hajrudin10/AndreiUW/KiCAD/V_01_00/Proximity_sensor_V_01_00/Prox_sens_V_01_00/Prox_sens_V_01_00_bot.png

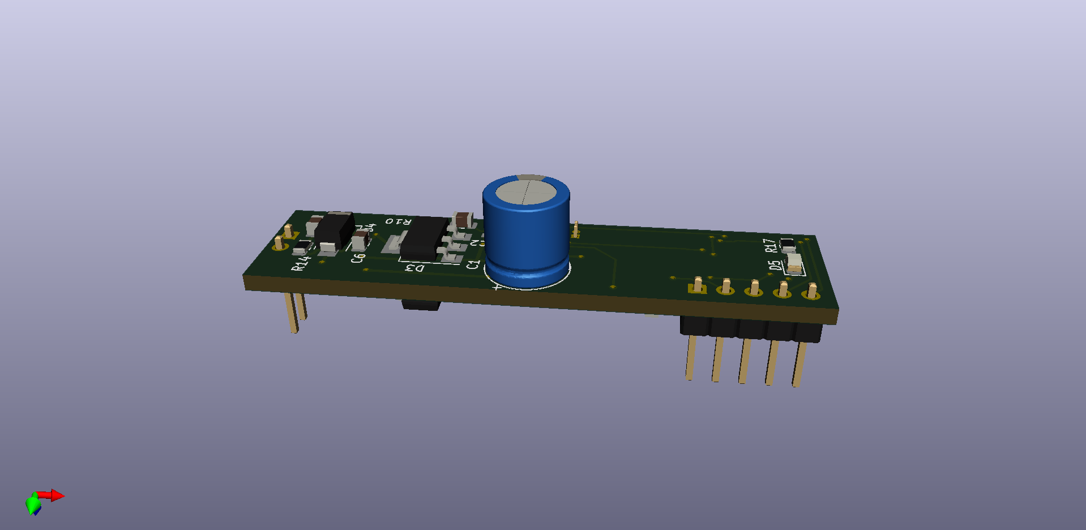
KiCAD/V_01_00/Proximity_sensor_V_01_00/Prox_sens_V_01_00/Prox_sens_V_01_00_bot.png
