hajrudin10/AndreiUW/TwoWireProximitySensor.pdf

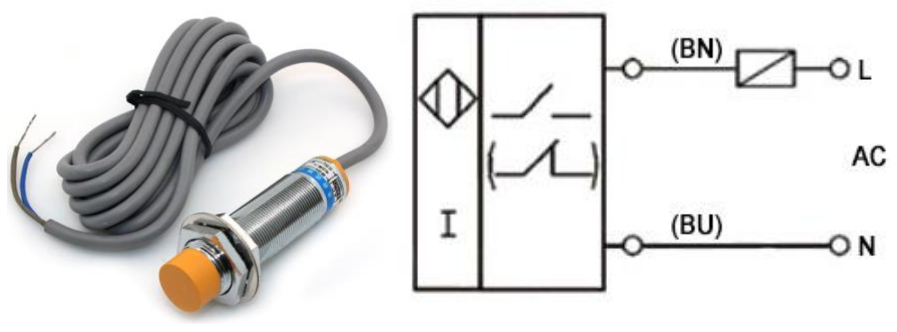
[picture p3: figure]

1. Design done in KiCAD
2. 230V input MP103GN based AC-DC 5V power supply
3. CY8C4014LQI-421 IC controls thyristor state + Capacitive Sensing connection
4. Zero crossing detection connected to CY8C4014LQI-421
5. M24SR02-Y (TSSOP8 package) NFC IC, connected to CY8C4014LQI-421 via I2C
6. PCB size: width 14mm, length <=55mm

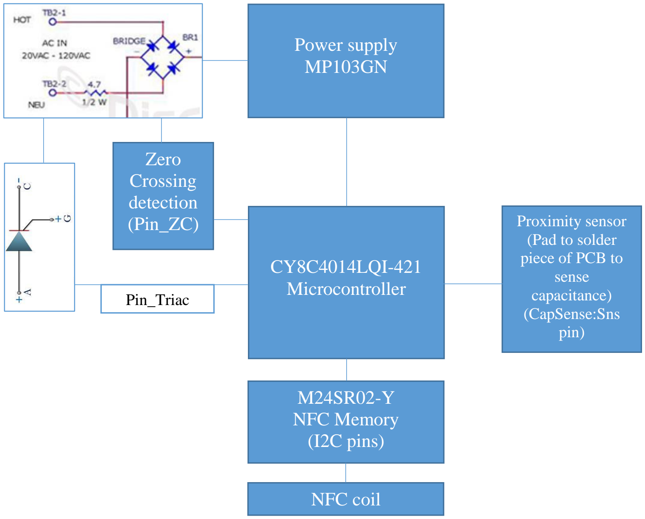
[picture p4: figure]
Power supply MP103GN; CY8C4014LQI-421 Microcontroller; Proximity sensor (Pad to solder piece of PCB to sense capacitance) (CapSense:Sns pin); M24SR02-Y NFC Memory (I2C pins); NFC coil; Zero Crossing detection (Pin_ZC); Pin_Triac

Functional diagram

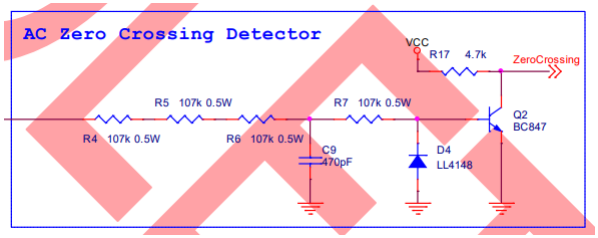
[picture p5: figure]

Zero Crossing detection

Thyristor gate control circuit

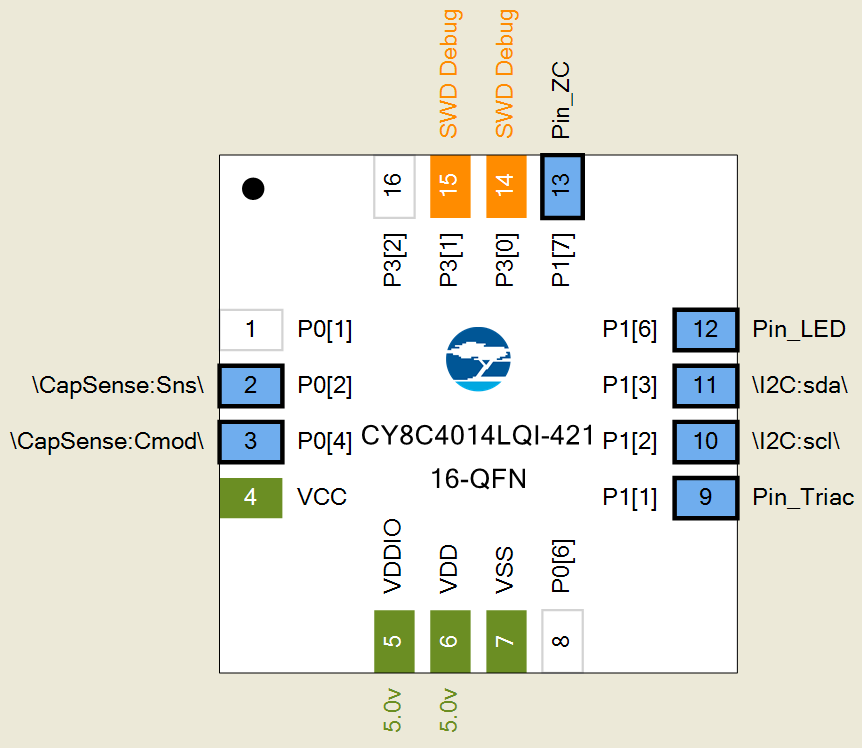
[picture p6: figure]

CapSense:Cmod – Capacitor connected to GND 2.2nF CapSense:Sns – Connected to proximity sensor
Pin_ZC – Connected to zeroCrossing detector output Pin_Triac – Thyristor control output
SWD Debug – Connected to programming pads on PCB Pin_LED – Status LED located on PCB
