hajrudin10/AndreiUW/Zero_crossing_detector2.PNG

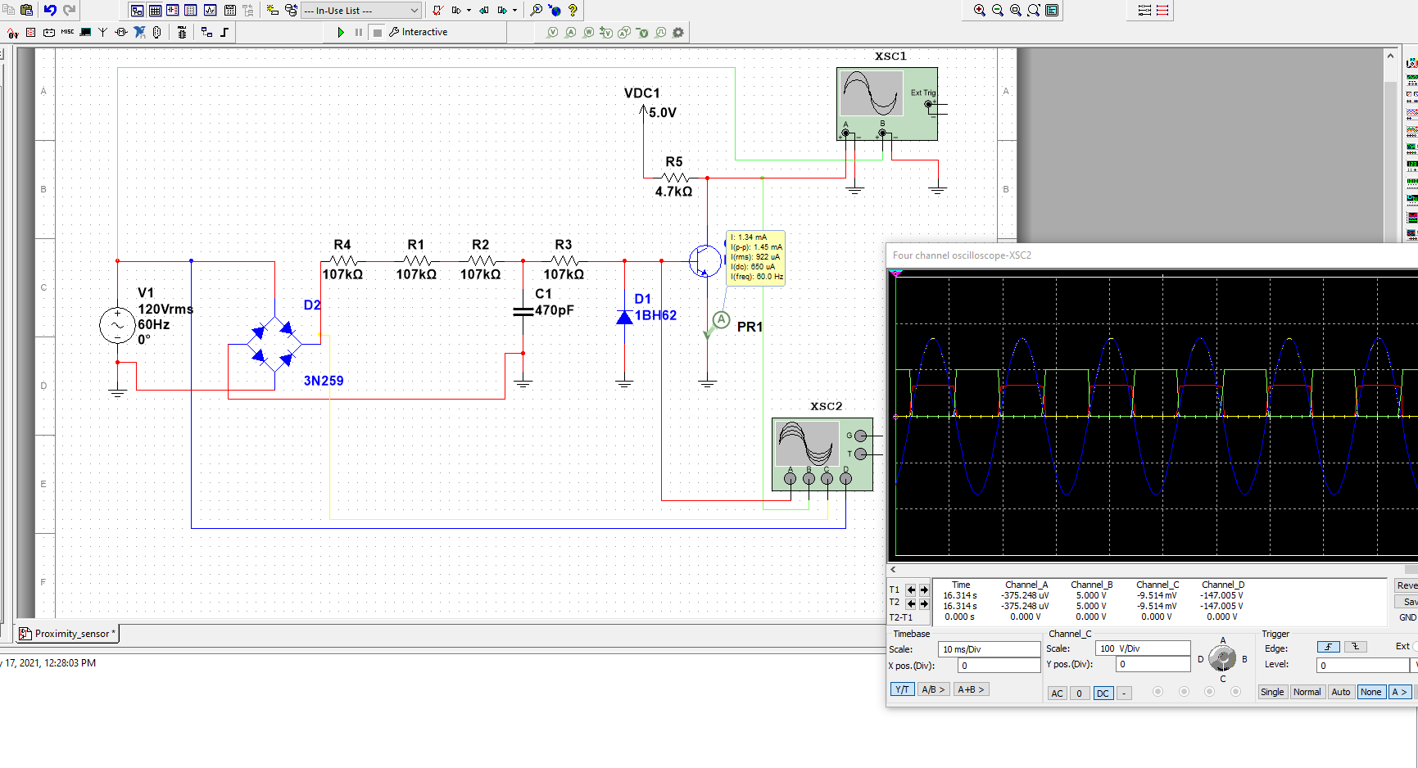
Zero_crossing_detector2.PNG
