hajrudin10/AndreiUW/Zero_crossing_detector3.PNG

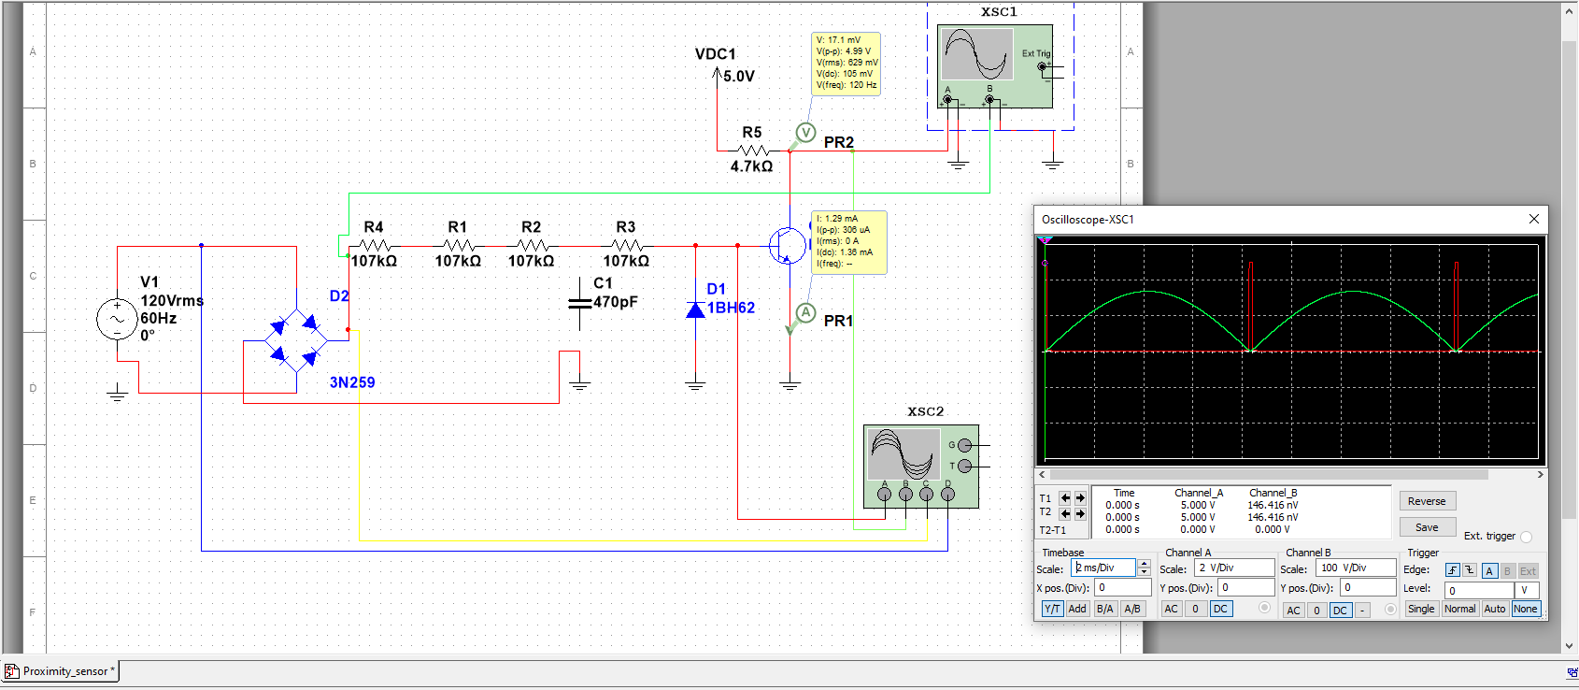
Zero_crossing_detector3.PNG
