hajrudin10/AndreiUW/Zero_crossing_detector4.PNG

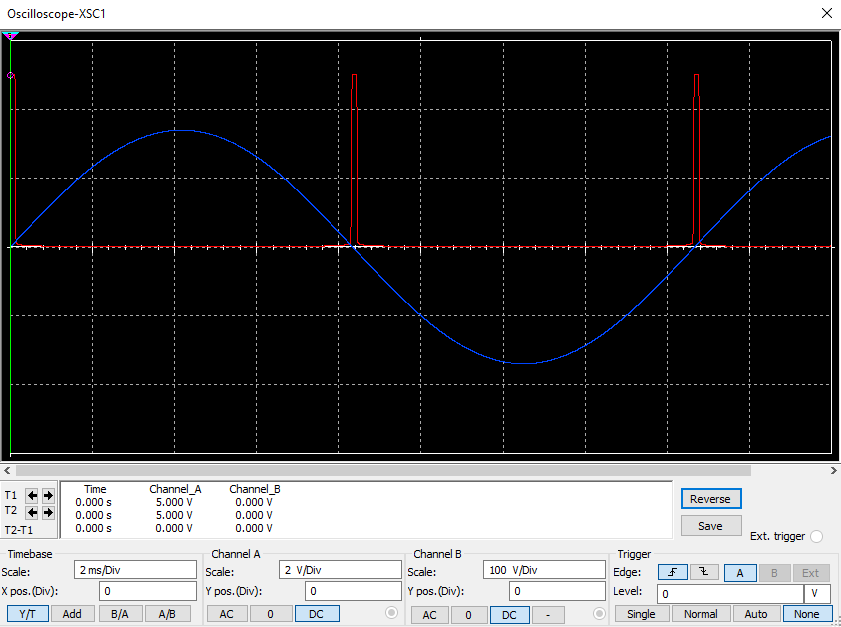
Zero_crossing_detector4.PNG
