hajrudin10/AndreiUW/Zero_crossing_detector.PNG

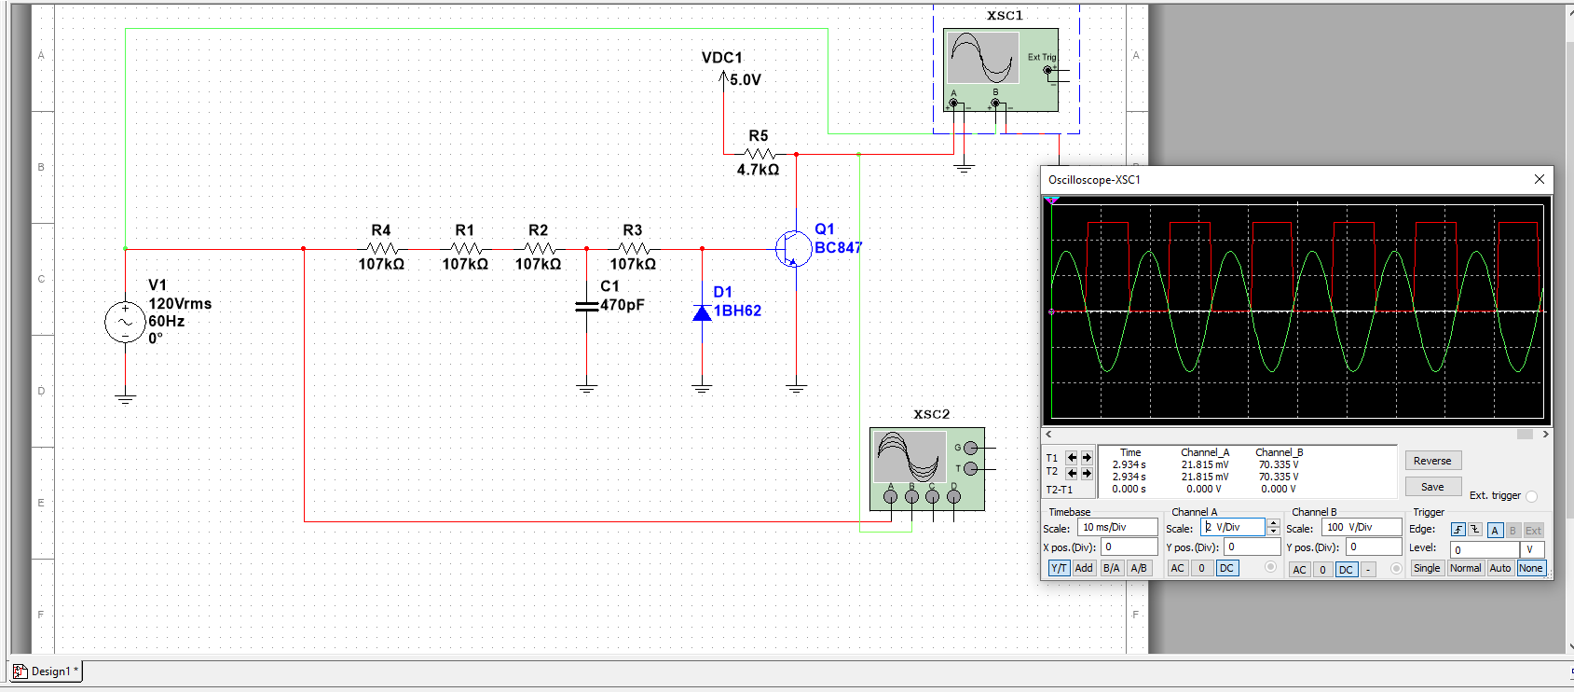
Zero_crossing_detector.PNG
