hajrudin10/AndreiUW/Zero_crossing_detector_new_1.PNG

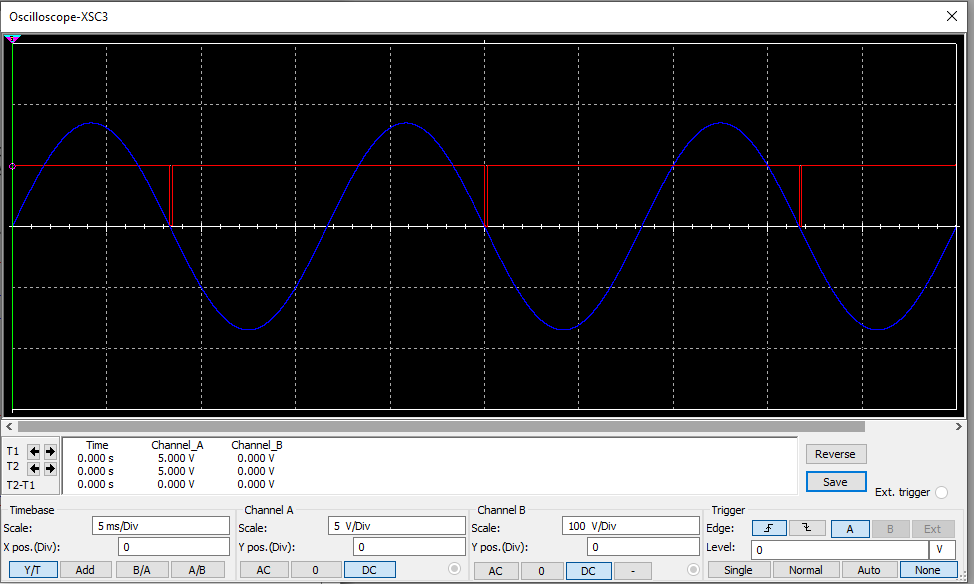
Zero_crossing_detector_new_1.PNG
