hajrudin10/AndreiUW/power_part_twps.pdf

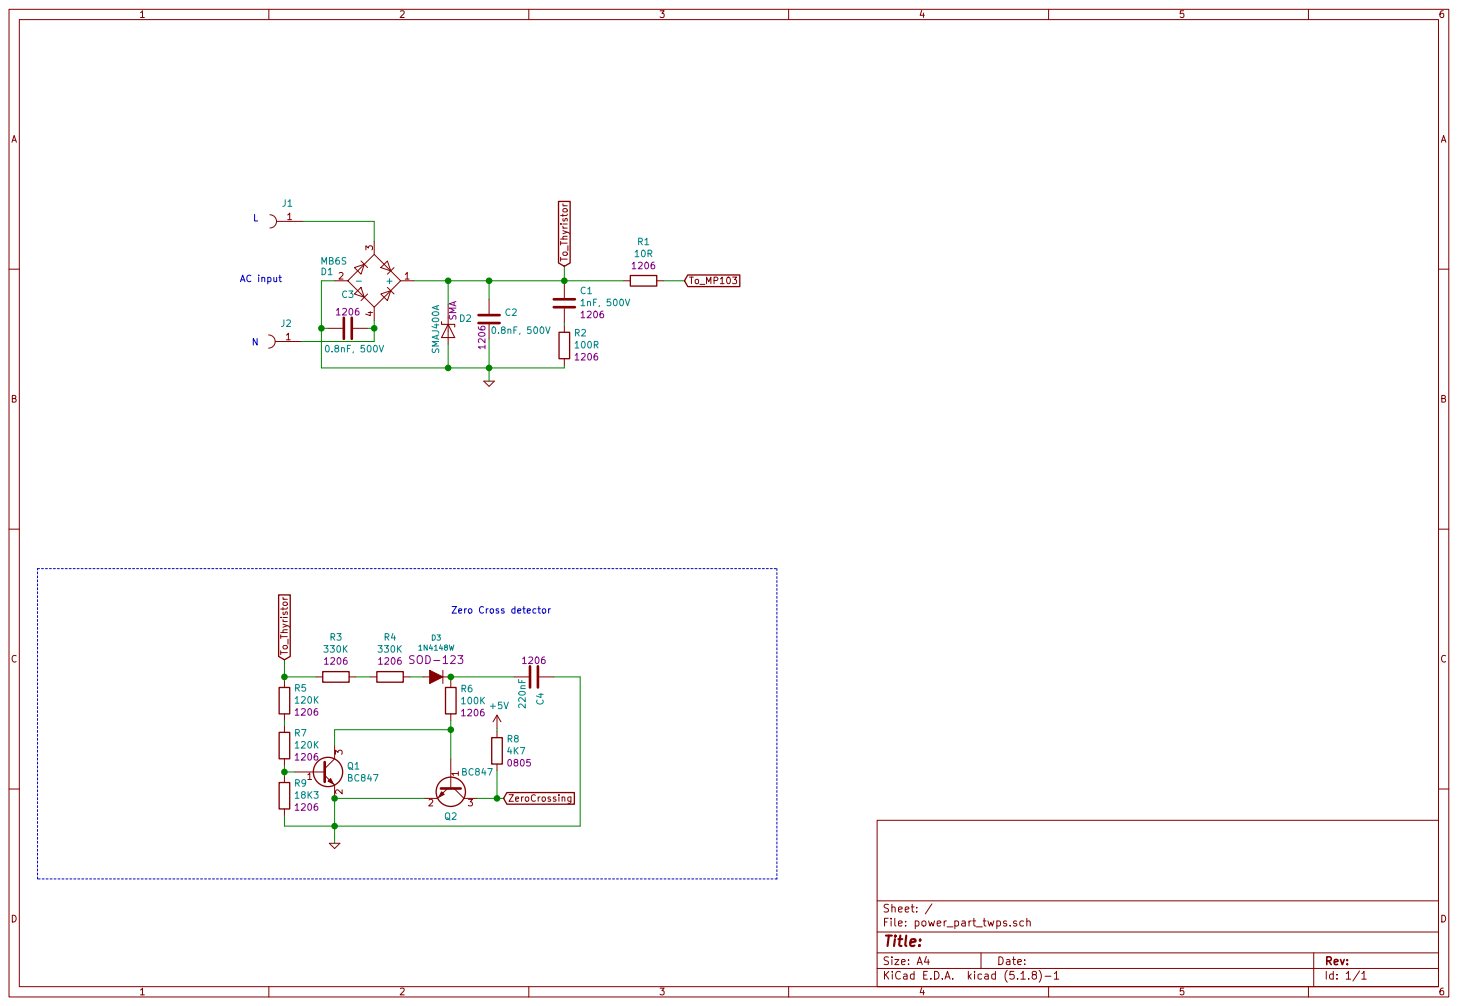
[picture p12: page 1]
