hajrudin10/AndreiUW/KiCAD/V_01_00/Proximity_sensor_V_01_00/Prox_sens_V_01_00/Prox_sens_V_01_00.pdf

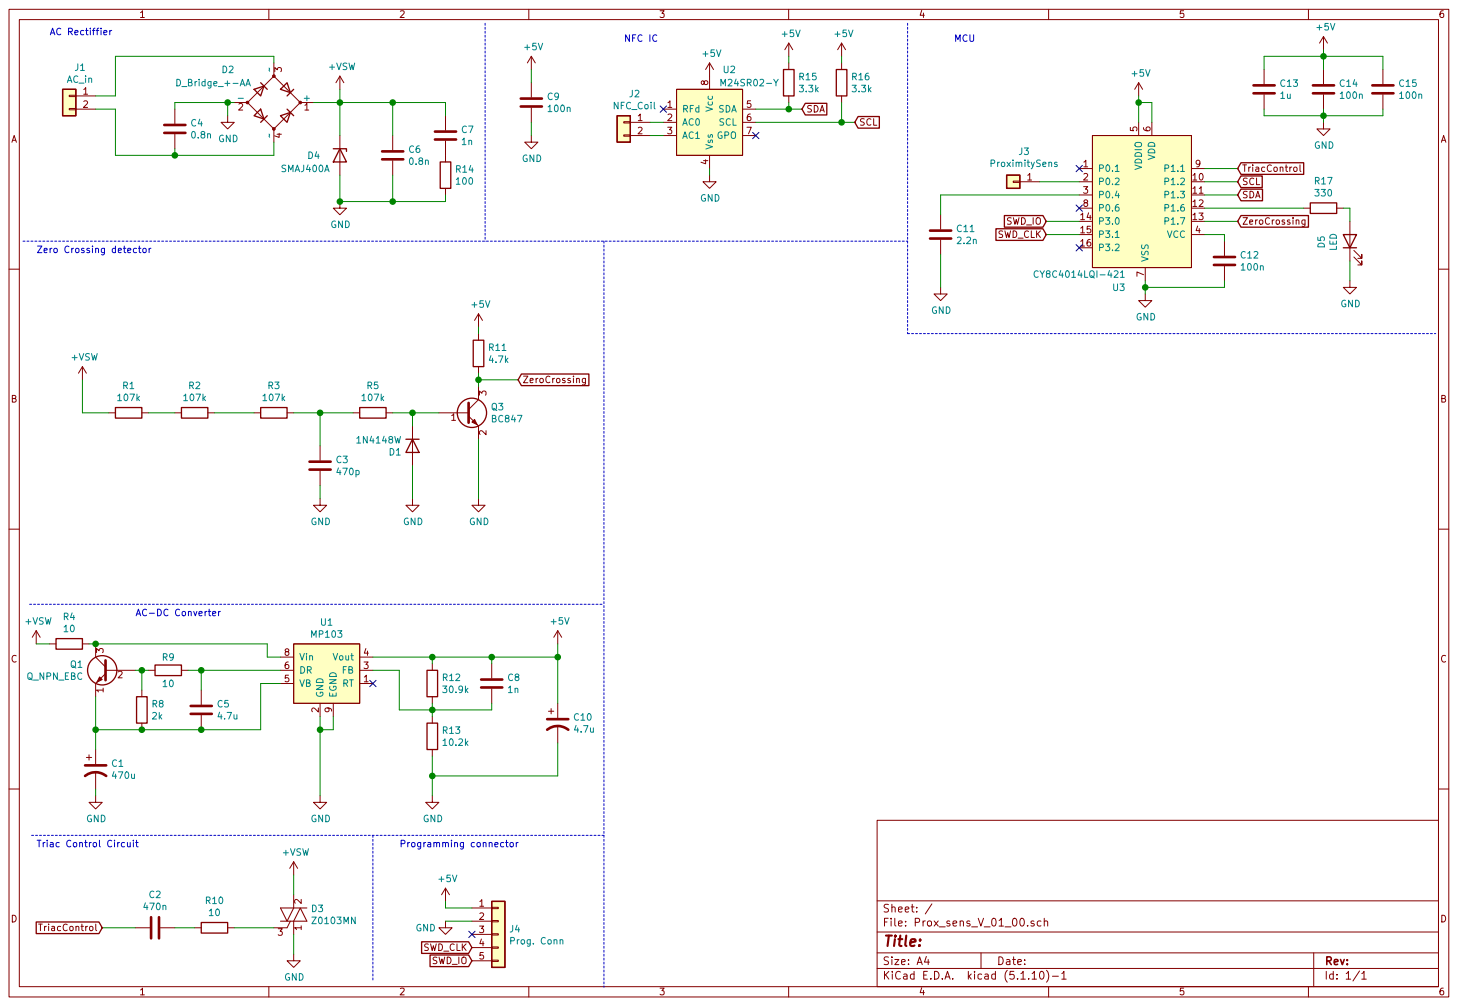
[picture p13: page 1]

2 FB 3 Vout 4 VB 5 DR 6 Vin 8 EGND
