hajrudin10/AndreiUW/(list of files, drawings)

Other design files:
Multisim/Proximity_sensor.ms14
