hajrudin10/AndreiUW/KiCAD/V_01_00/Proximity_sensor_V_01_00/Prox_sens_V_01_00/Prox_sens_V_01_00.kicad_pcb

## KiCad design KiCAD/V_01_00/Proximity_sensor_V_01_00/Prox_sens_V_01_00/Prox_sens_V_01_00.kicad_pcb (2021-08-02)

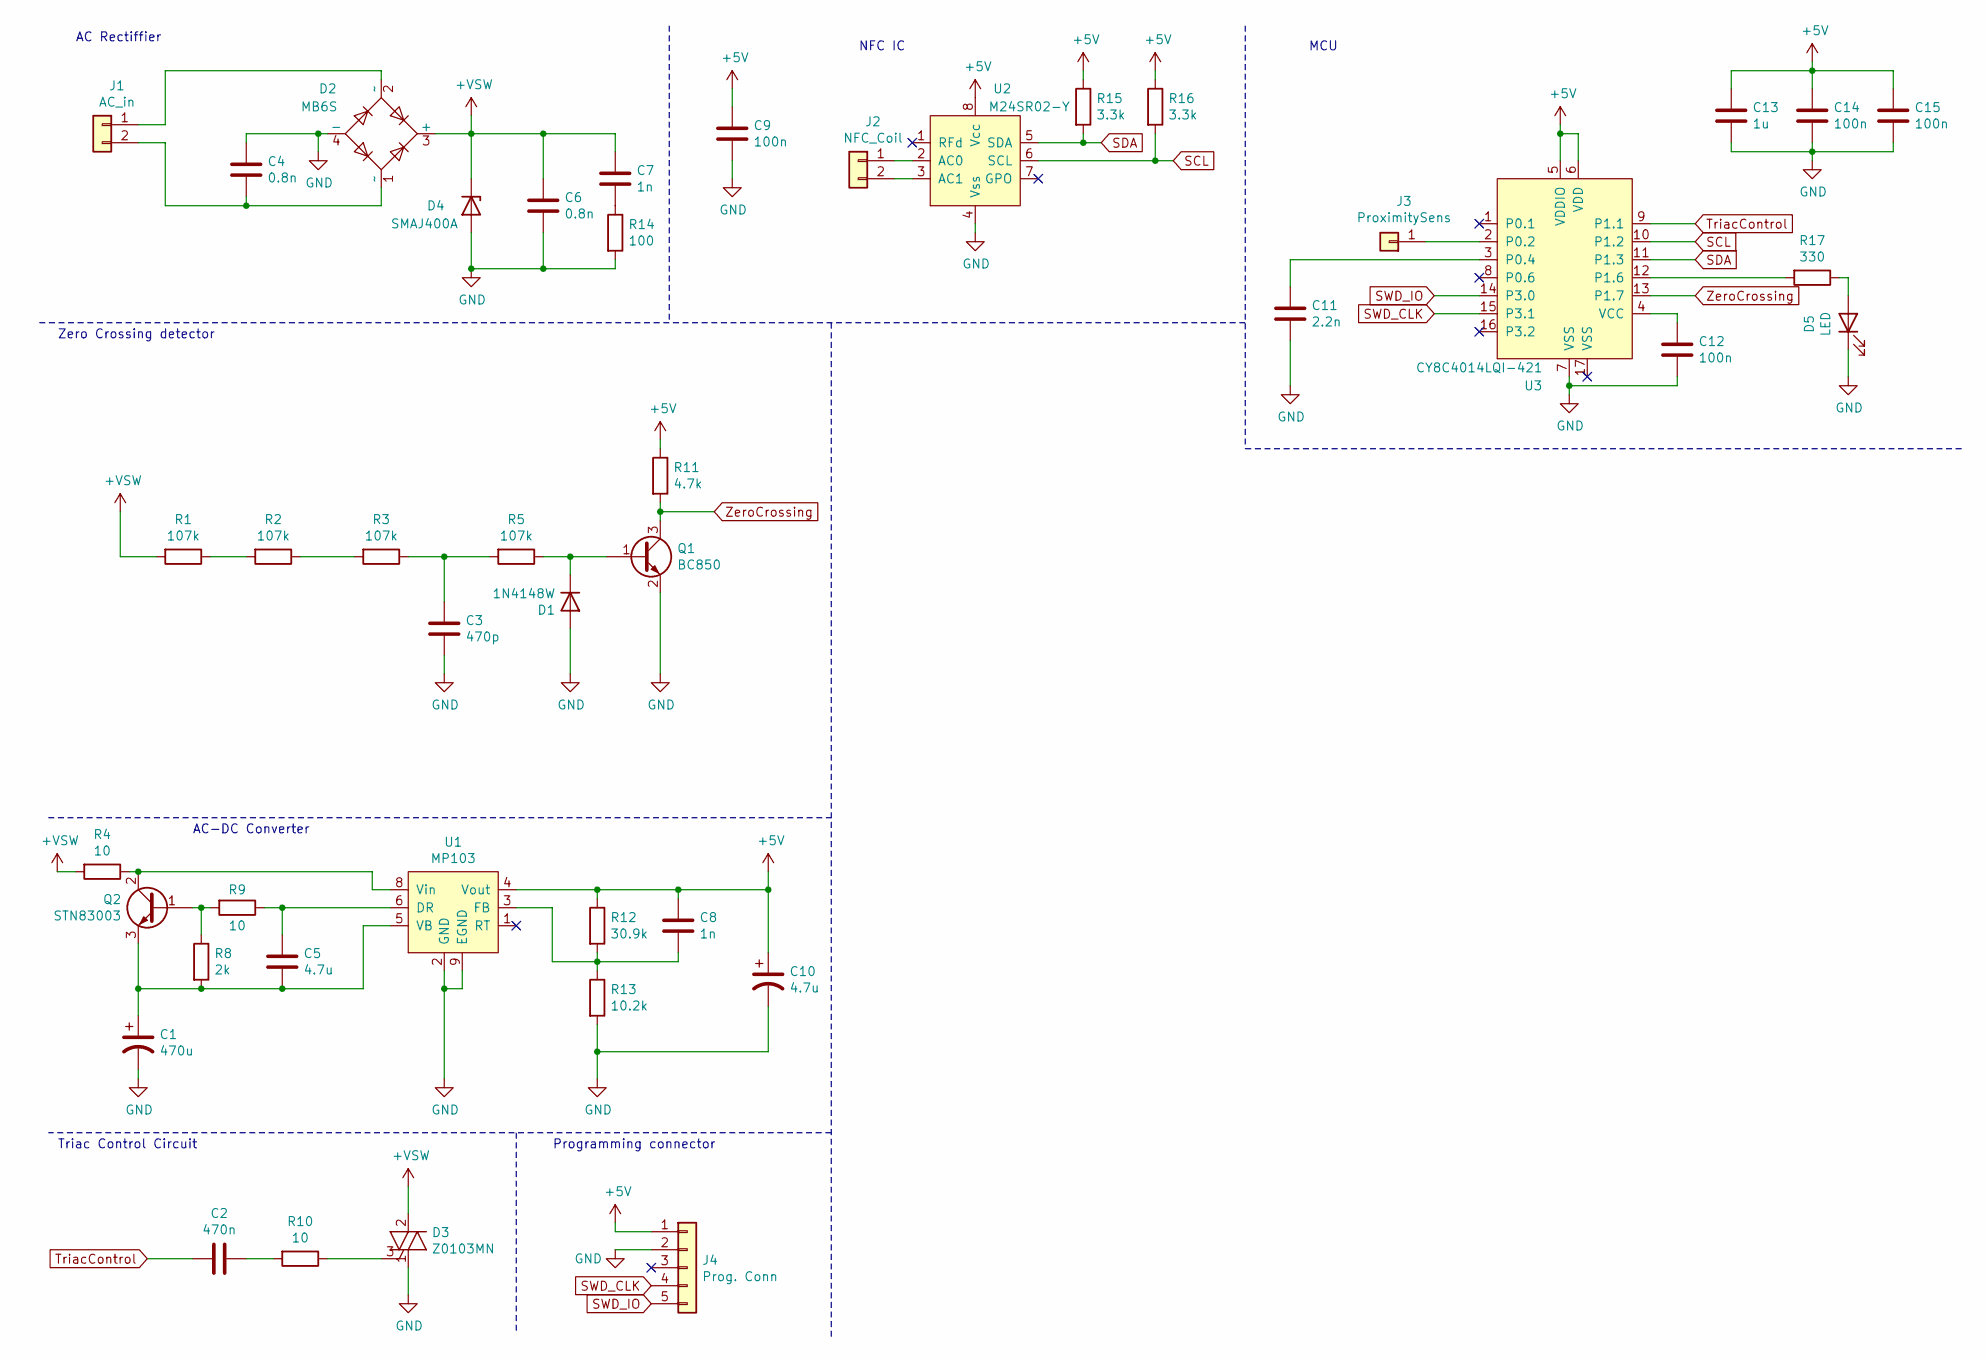
[picture p14: schematic Prox_sens_V_01_00.sch]

Parts:
C1: 470u; CP_Radial_D8.0mm_P3.50mm
C2: 470n; C_1206_3216Metric
C3: 470p; C_0805_2012Metric
C4, C6: 0.8n; C_1206_3216Metric
C5: 4.7u; C_0805_2012Metric
C7: 1n; C_1206_3216Metric
C8: 1n; C_0805_2012Metric
C9, C12, C14, C15: 100n; C_0805_2012Metric
C10: 4.7u; CP_EIA-3216-18_Kemet-A
C11: 2.2n; C_0805_2012Metric
C13: 1u; C_0805_2012Metric
D1: 1N4148W; D_0805_2012Metric
D2: MB6S; TO-269AA
D3: Z0103MN; SOT-223
D4: SMAJ400A; D_SMA
D5: LED; LED_0805_2012Metric
J1: AC_in; PinHeader_1x02_P5.08mm_Vertical
J2: NFC_Coil; PinHeader_1x02_P1.00mm_Vertical
J3: ProximitySens; Prox_sens
J4: Prog. Conn; PinHeader_1x05_P2.54mm_Vertical
Q1: BC850; SOT-23
Q2: STN83003; SOT-223-3_TabPin2
R1, R2, R3, R5: 107k; R_0805_2012Metric
R4, R10: 10; R_1206_3216Metric
R8: 2k; R_0805_2012Metric
R9: 10; R_0805_2012Metric
R11: 4.7k; R_0805_2012Metric
R12: 30.9k; R_0805_2012Metric
R13: 10.2k; R_0805_2012Metric
R14: 100; R_1206_3216Metric
R15, R16: 3.3k; R_0805_2012Metric
R17: 330; R_0805_2012Metric
U1: MP103; SOIC-8-1EP_3.9x4.9mm_P1.27mm_EP2.41x3.3mm
U2: M24SR02-Y; TSSOP-8_4.4x3mm_P0.65mm
U3: CY8C4014LQI-421; QFN-16-1EP_3x3mm_P0.5mm_EP1.75x1.75mm

Connections:
+5V: C8.1, C9.1, C10.1, C13.1, C14.1, C15.1, J4.1, R11.1, R12.1, R15.1, R16.1, U1.4 (Vout), U2.8 (Vcc), U3.5 (VDDIO), U3.6 (VDD)
+VSW: C6.1, C7.1, D2.3 (+), D3.2 (A2), D3.4 (A4), D4.1 (K), R1.2, R4.2
GND: C1.2, C3.2, C4.1, C6.2, C9.2, C10.2, C11.2, C12.2, C13.2, C14.2, C15.2, D1.2 (A), D2.4 (-), D3.1 (A1), D4.2 (A), D5.1 (K), J4.2, Q1.2 (E), R13.2, R14.2, U1.2 (GND), U1.9 (EGND), U2.4 (Vss), U3.7 (VSS)
unnamed: C1.1, C5.2, Q2.3 (E), R8.2, U1.5 (VB)
unnamed: C2.1, R10.2
unnamed: C3.1, R3.1, R5.2
unnamed: C4.2, D2.1 (~~), J1.2
unnamed: C5.1, R9.1, U1.6 (DR)
unnamed: C7.2, R14.1
unnamed: C8.2, R12.2, R13.1, U1.3 (FB)
unnamed: C11.1, U3.3 (P0.4)
unnamed: C12.1, U3.4 (VCC)
unnamed: D1.1 (K), Q1.1 (B), R5.1
unnamed: D2.2 (~~), J1.1
unnamed: D3.3 (G), R10.1
unnamed: D5.2 (A), R17.1
unnamed: J2.1, U2.2 (AC0)
unnamed: J2.2, U2.3 (AC1)
unnamed: J3.1, U3.2 (P0.2)
unnamed: Q2.1 (B), R8.1, R9.2
unnamed: Q2.2 (C), R4.1, U1.8 (Vin)
unnamed: R1.1, R2.2
unnamed: R2.1, R3.2
unnamed: R17.2, U3.12 (P1.6)
SCL: R16.2, U2.6 (SCL), U3.10 (P1.2)
SDA: R15.2, U2.5 (SDA), U3.11 (P1.3)
SWD_CLK: J4.4, U3.15 (P3.1)
SWD_IO: J4.5, U3.14 (P3.0)
TriacControl: C2.2, U3.9 (P1.1)
ZeroCrossing: Q1.3 (C), R11.2, U3.13 (P1.7)

Notes on the sheet:
AC Rectiffier
Zero Crossing detector
Triac Control Circuit
AC-DC Converter
NFC IC
MCU
Programming connector

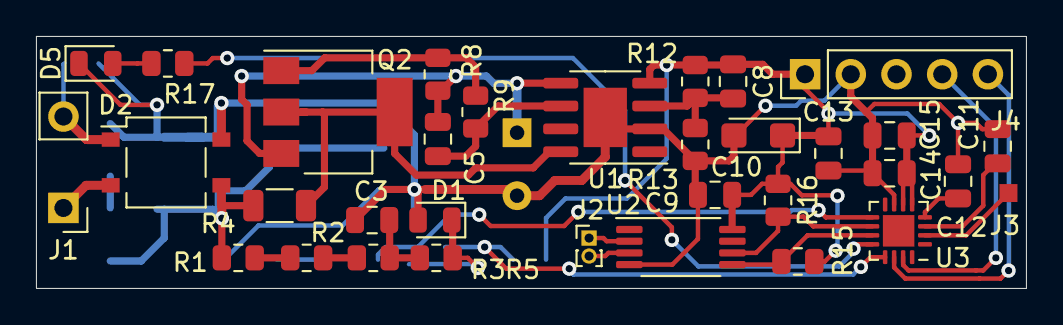
[picture p15: board Prox_sens_V_01_00.kicad_pcb from above]

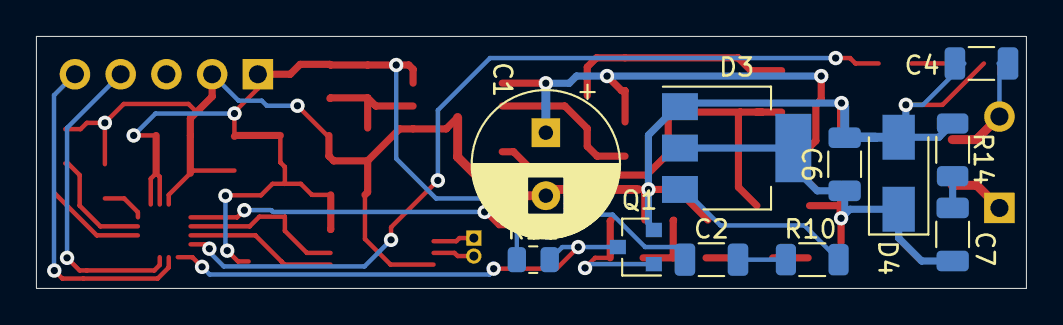
[picture p16: board Prox_sens_V_01_00.kicad_pcb from below]

Board: 2 copper layers, 55.0 x 14.0 mm, 44 parts (11 on the bottom side), 30 nets.
